DonNikolas/SmartKnob-ESP32/README.md

# SmartKnob-ESP32
Sound-controlled haptic smart knob for smart home control — ESP32-S3, FOC motor feedback, clap detection, MQTT/Home Assistant

## 3D-Render
cfa85a10-b2ae-4bf3-83a7-a0ef6e1e3006
