DonNikolas/SmartKnob-ESP32/electronics/SmartKnob-Screen/README.md

# SmartKnob Screen PCB

The screen PCB design was copied unchanged from SeedLabs.

Source: https://github.com/SeedLabs-it/smartknob-hardware

The original files are stored here for use with my SmartKnob project.
This PCB was not designed by me.

See license.md for the original SeedLabs hardware license.
