DonNikolas/SmartKnob-ESP32/reference/arduino-display-prototype/preview/SmartKnob_Animation.gif

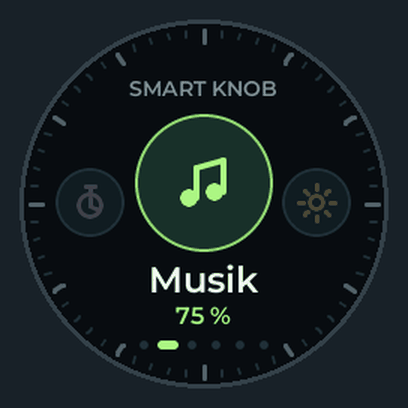
reference/arduino-display-prototype/preview/SmartKnob_Animation.gif
