DonNikolas/SmartKnob-ESP32/reference/arduino-display-prototype/preview/Uebersicht.png

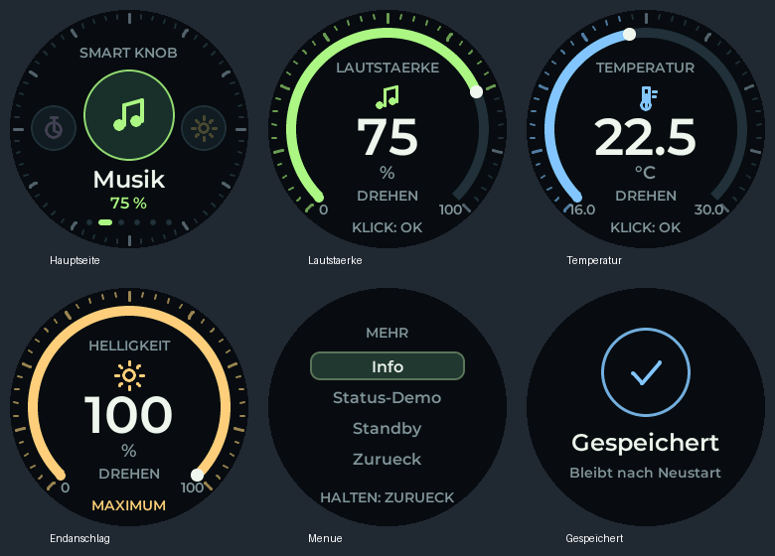
reference/arduino-display-prototype/preview/Uebersicht.png
