DonNikolas/SmartKnob-ESP32/reference/arduino-display-prototype/preview/Uhr_und_Helligkeit.png

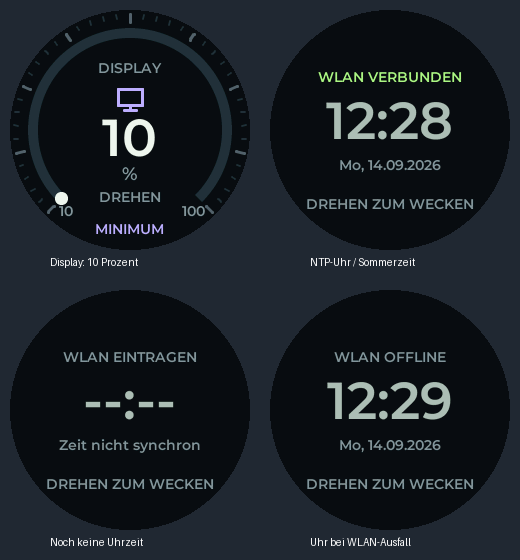
reference/arduino-display-prototype/preview/Uhr_und_Helligkeit.png
