DonNikolas/SmartKnob-ESP32/electronics/SmartKnob-Base/SmartKnob-NB.step

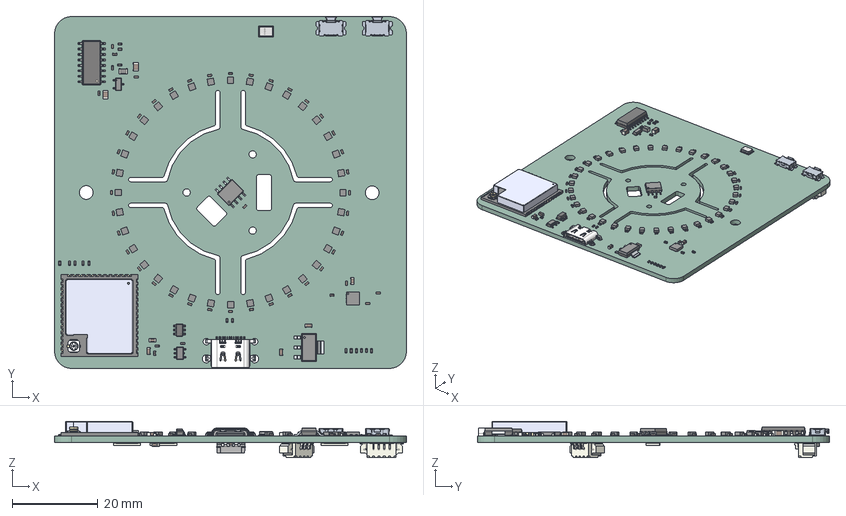
[picture p9: CAD file, 2026-10-14]
electronics/SmartKnob-Base/SmartKnob-NB.step
82.0 x 82.0 x 8.43 mm
C_0402_1005Metric x 50
Pins x 36
R_0402_1005Metric x 18
ESP32-S3-WROOM-1U-N16R8
C_0603_1608Metric x 6
C_0805_2012Metric x 2
SOP-16_4.4x10.4mm_P1.27mm
BODY-SOT
LEAD-SOT x 5
LEAD-DUMMY
PinsArrayL x 2
FilletPinR x 2
L_0805_2012Metric
ThermalPin
PinsArrayLR x 2
PinsArrayTB
SOT-23-6
USB4510
ICS-41350
Molex_53261_0471
Molex_53261_0371
VEML7700-TT
R_2512_6332Metric x 4
Bosch_LGA_8_25x25mm_P065mm_ClockwisePinNumbering
Sma8947_PCB
