DonNikolas/SmartKnob-ESP32/mechanical/enclosure-v4/Screen Platform.step

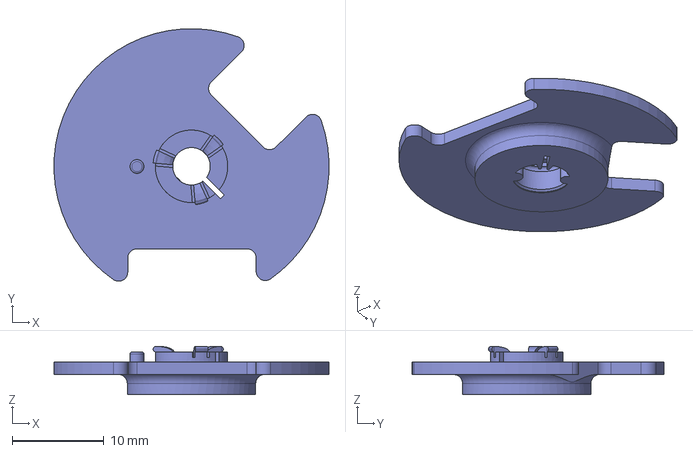
[picture p10: CAD file, 2026-10-22]
mechanical/enclosure-v4/Screen Platform.step
30.0 x 27.5 x 5.25 mm
