DonNikolas/SmartKnob-ESP32/mechanical/enclosure-v4/Back Plate v4.step

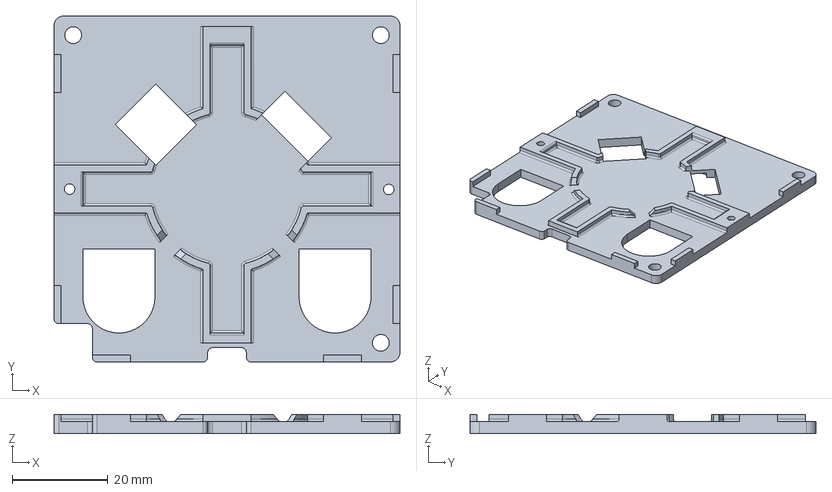
[picture p11: CAD file, 2026-10-22]
mechanical/enclosure-v4/Back Plate v4.step
72.2 x 72.2 x 4.00 mm
