DonNikolas/SmartKnob-ESP32/mechanical/enclosure-v4/Knob.step

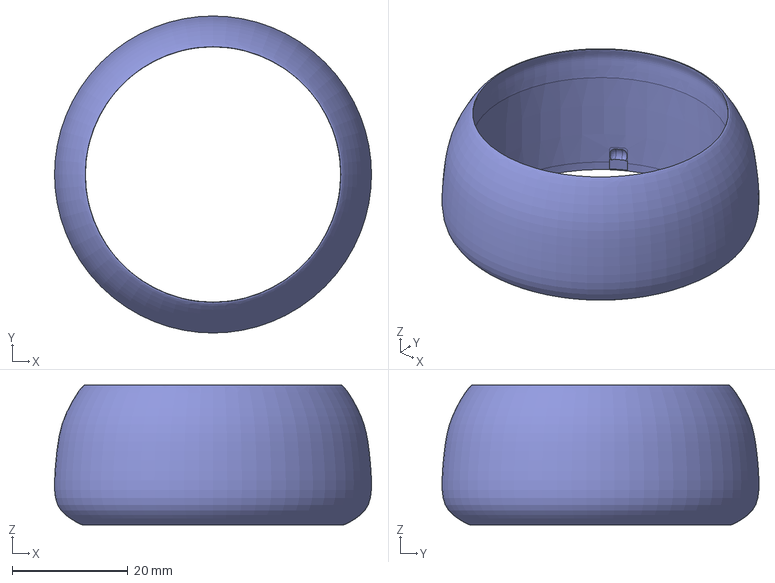
[picture p12: CAD file, 2026-10-21]
mechanical/enclosure-v4/Knob.step
54.8 x 54.8 x 24.2 mm
