DonNikolas/SmartKnob-ESP32/mechanical/enclosure-v4/Motor Spacer.step

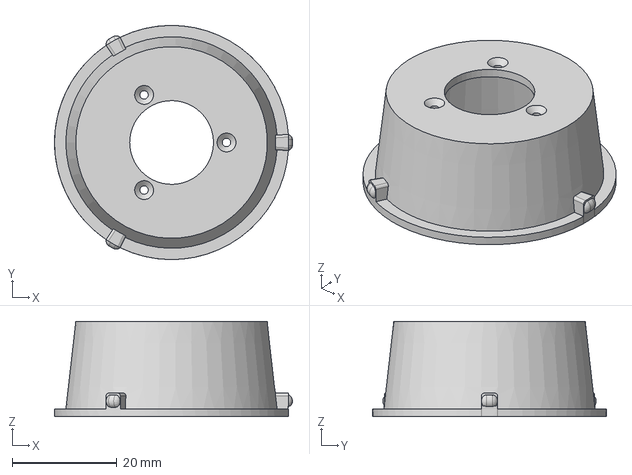
[picture p13: CAD file, 2026-10-21]
mechanical/enclosure-v4/Motor Spacer.step
45.5 x 44.8 x 18.2 mm
