DonNikolas/SmartKnob-ESP32/mechanical/enclosure-v3/Base Enclosure V3.step

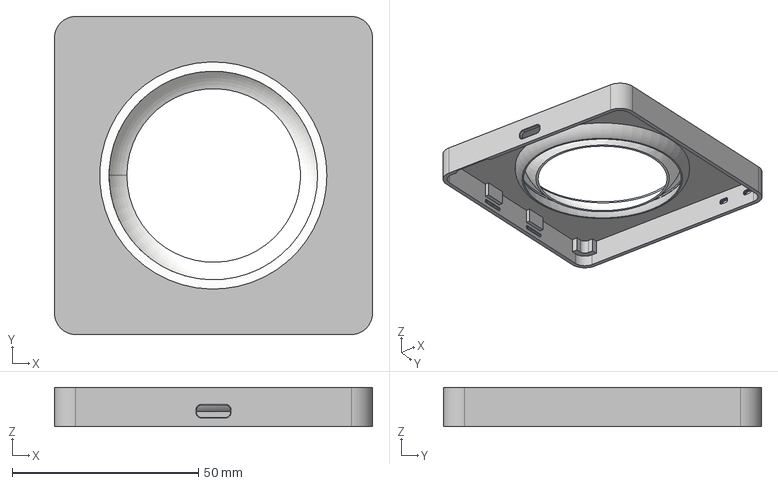
[picture p14: CAD file, 2026-10-19, an earlier design]
mechanical/enclosure-v3/Base Enclosure V3.step
85.4 x 85.4 x 10.5 mm
