DonNikolas/SmartKnob-ESP32/(list of files, cad)

Other CAD files:
mechanical/enclosure-v4/Button Set.step
mechanical/enclosure-v4/Motor Shaft.step
mechanical/enclosure-v4/Base Enclosure.step
mechanical/enclosure-v4/Display Spacer.step
mechanical/enclosure-v3/SmartKnob Enclosure Project.3mf
mechanical/enclosure-v3/SmartKnob-Assembly.f3z
mechanical/enclosure-v4/SmartKnob Enclosure.f3z
