DonNikolas/SmartKnob-ESP32/firmware/docs/tests/motor-offset-profile-01.txt

CALIBRATION v6: release rotor. About 2 minutes; x stops.
3 turns for direction, 20 forward + 20 reverse, then full-turn offset profiling.
Motor voltage: 0.50 V. Short TRACK LOST samples skipped; motion stays open-loop.
Pole pairs: 7 | Forward estimate: 7.041 | Reverse estimate: 7.062
Direction: CCW | Offset agreement: 23.08 electrical deg
Offset coherence: 0.906 / 0.922 | Electrical zero: 5.118509 rad
Samples: 116289 | CRC errors: 0 | TRACK LOST: 2490 | Weak field: 116289
RESULT: FAIL - electrical offset is not repeatable enough.
=== OFFSET PROFILE v6 - MOTOR OFF ===
Early window: 100-200 ms; late window: 700-800 ms after arrival.
Angles in degrees. Offset is electrical; settling and span are mechanical.
This profile includes motor, mechanics and sensor errors; it is not ground truth.
pass,step,command_elec_deg,sensor_mech_deg,offset_elec_deg,late_minus_early_mech_deg,late_span_mech_deg,early_samples,late_samples
FWD,0,0.000,247.799,65.407,-0.0062,0.2298,98,100
FWD,1,78.750,239.681,43.480,0.0202,0.1257,95,98
FWD,2,157.500,227.355,51.015,-0.0434,0.1319,97,99
FWD,3,236.250,217.053,44.381,0.0222,0.1328,98,99
FWD,4,315.000,208.491,25.561,0.0089,0.1598,99,101
FWD,5,393.750,195.226,39.666,0.0148,0.1144,98,100
FWD,6,472.500,184.145,38.484,0.0014,0.1332,96,98
FWD,7,551.250,175.053,23.378,0.0098,0.1185,98,99
FWD,8,630.000,161.505,39.461,0.0003,0.1456,100,101
FWD,9,708.750,152.231,25.633,0.0037,0.1309,98,101
FWD,10,787.500,141.175,24.276,0.0263,0.1468,99,99
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
REV,2,157.500,223.969,74.715,-0.0004,0.1414,99,99
REV,1,78.750,236.793,63.700,0.0292,0.1495,100,99
REV,0,0.000,247.785,65.504,-0.0056,0.2021,98,99
Maximum absolute settling: 0.0989 mechanical deg
Maximum late-window span: 0.2298 mechanical deg
Profile rows: 66/66
=== END OFFSET PROFILE ===
