DonNikolas/SmartKnob-ESP32/firmware/docs/tests/motor-offset-profile-02.txt

CALIBRATION v6: release rotor. About 2 minutes; x stops.
3 turns for direction, 20 forward + 20 reverse, then full-turn offset profiling.
Motor voltage: 0.50 V. Short TRACK LOST samples skipped; motion stays open-loop.
Pole pairs: 7 | Forward estimate: 6.968 | Reverse estimate: 6.990
Direction: CCW | Offset agreement: 23.26 electrical deg
Offset coherence: 0.918 / 0.909 | Electrical zero: 5.088051 rad
Samples: 116287 | CRC errors: 0 | TRACK LOST: 2275 | Weak field: 116287
RESULT: FAIL - electrical offset is not repeatable enough.
=== OFFSET PROFILE v6 - MOTOR OFF ===
Early window: 100-200 ms; late window: 700-800 ms after arrival.
Angles in degrees. Offset is electrical; settling and span are mechanical.
This profile includes motor, mechanics and sensor errors; it is not ground truth.
pass,step,command_elec_deg,sensor_mech_deg,offset_elec_deg,late_minus_early_mech_deg,late_span_mech_deg,early_samples,late_samples
FWD,0,0.000,101.263,11.158,-0.0478,0.1546,98,100
FWD,1,78.750,94.223,-18.315,-0.0364,0.1451,98,101
FWD,2,157.500,80.478,-0.846,0.0021,0.1157,99,99
FWD,3,236.250,69.659,-3.869,0.0033,0.1565,100,101
FWD,4,315.000,59.649,-12.548,-0.0109,0.0923,98,100
FWD,5,393.750,48.784,-15.242,-0.0707,0.1314,100,100
FWD,6,472.500,38.769,-23.885,0.0020,0.1104,99,98
FWD,7,551.250,28.590,-31.379,0.0043,0.1305,97,101
FWD,8,630.000,16.055,-22.388,0.0320,0.1325,97,101
FWD,9,708.750,5.448,-26.890,-0.0278,0.1777,98,97
FWD,10,787.500,351.016,-4.618,-0.0126,0.1559,99,98
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
REV,2,157.500,77.616,19.184,-0.0078,0.1611,98,99
REV,1,78.750,88.979,18.393,0.0207,0.1534,99,98
REV,0,0.000,101.257,11.200,0.0103,0.1409,95,100
Maximum absolute settling: 0.0707 mechanical deg
Maximum late-window span: 0.2004 mechanical deg
Profile rows: 66/66
=== END OFFSET PROFILE ===
