DonNikolas/SmartKnob-ESP32/firmware/docs/tests/microphone-test.txt

Time: 7 s | RMS: 8.0 | P-P: 92 | Mean: 608.8 | Clipped: 0 | Samples: 8192
Time: 7 s | RMS: 8.2 | P-P: 108 | Mean: 608.6 | Clipped: 0 | Samples: 8192
Time: 8 s | RMS: 8.3 | P-P: 113 | Mean: 609.2 | Clipped: 0 | Samples: 8192
Time: 8 s | RMS: 8.2 | P-P: 95 | Mean: 608.7 | Clipped: 0 | Samples: 8192
Time: 9 s | RMS: 8.1 | P-P: 96 | Mean: 608.7 | Clipped: 0 | Samples: 8192
Time: 9 s | RMS: 8.1 | P-P: 90 | Mean: 608.3 | Clipped: 0 | Samples: 8192
Time: 10 s | RMS: 8.4 | P-P: 103 | Mean: 608.4 | Clipped: 0 | Samples: 8192
Time: 10 s | RMS: 8.2 | P-P: 100 | Mean: 609.0 | Clipped: 0 | Samples: 8192
Time: 11 s | RMS: 8.2 | P-P: 103 | Mean: 608.5 | Clipped: 0 | Samples: 8192
Time: 11 s | RMS: 8.3 | P-P: 99 | Mean: 609.2 | Clipped: 0 | Samples: 8192
Time: 12 s | RMS: 8.1 | P-P: 108 | Mean: 609.0 | Clipped: 0 | Samples: 8192
Time: 12 s | RMS: 8.2 | P-P: 109 | Mean: 608.8 | Clipped: 0 | Samples: 8192
Time: 13 s | RMS: 8.0 | P-P: 106 | Mean: 608.4 | Clipped: 0 | Samples: 8192
Time: 13 s | RMS: 7.9 | P-P: 90 | Mean: 609.5 | Clipped: 0 | Samples: 8192
Time: 14 s | RMS: 8.0 | P-P: 99 | Mean: 608.5 | Clipped: 0 | Samples: 8192
Time: 14 s | RMS: 8.1 | P-P: 105 | Mean: 608.6 | Clipped: 0 | Samples: 8192
Time: 15 s | RMS: 8.1 | P-P: 105 | Mean: 608.6 | Clipped: 0 | Samples: 8192
Time: 15 s | RMS: 8.4 | P-P: 97 | Mean: 609.3 | Clipped: 0 | Samples: 8192
Time: 16 s | RMS: 8.5 | P-P: 101 | Mean: 608.8 | Clipped: 0 | Samples: 8192
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
Time: 85 s | RMS: 8.2 | P-P: 111 | Mean: 608.7 | Clipped: 0 | Samples: 8192
Time: 85 s | RMS: 7.8 | P-P: 94 | Mean: 608.7 | Clipped: 0 | Samples: 8192
Time: 86 s | RMS: 8.3 | P-P: 101 | Mean: 608.5 | Clipped: 0 | Samples: 8192
Time: 86 s | RMS: 8.1 | P-P: 109 | Mean: 608.6 | Clipped: 0 | Samples: 8192
Time: 87 s | RMS: 8.1 | P-P: 102 | Mean: 608.9 | Clipped: 0 | Samples: 8192
Time: 87 s | RMS: 7.9 | P-P: 96 | Mean: 609.5 | Clipped: 0 | Samples: 8192
Time: 88 s | RMS: 8.3 | P-P: 107 | Mean: 608.4 | Clipped: 0 | Samples: 8192
Time: 88 s | RMS: 8.0 | P-P: 95 | Mean: 609.2 | Clipped: 0 | Samples: 8192
Time: 89 s | RMS: 8.0 | P-P: 104 | Mean: 609.0 | Clipped: 0 | Samples: 8192
Time: 89 s | RMS: 8.0 | P-P: 105 | Mean: 609.8 | Clipped: 0 | Samples: 8192
Time: 90 s | RMS: 8.0 | P-P: 118 | Mean: 609.0 | Clipped: 0 | Samples: 8192
Time: 90 s | RMS: 7.8 | P-P: 103 | Mean: 609.0 | Clipped: 0 | Samples: 8192
Time: 91 s | RMS: 7.8 | P-P: 84 | Mean: 609.2 | Clipped: 0 | Samples: 8192
Time: 92 s | RMS: 7.6 | P-P: 100 | Mean: 610.0 | Clipped: 0 | Samples: 8192
Time: 92 s | RMS: 8.3 | P-P: 102 | Mean: 609.2 | Clipped: 0 | Samples: 8192
Time: 93 s | RMS: 8.0 | P-P: 104 | Mean: 608.8 | Clipped: 0 | Samples: 8192
Time: 93 s | RMS: 8.4 | P-P: 105 | Mean: 608.9 | Clipped: 0 | Samples: 8192
Time: 94 s | RMS: 8.2 | P-P: 106 | Mean: 609.0 | Clipped: 0 | Samples: 8192
Time: 94 s | RMS: 8.1 | P-P: 116 | Mean: 608.9 | Clipped: 0 | Samples: 8192
Time: 95 s | RMS: 8.2 | P-P: 102 | Mean: 609.1 | Clipped: 0 | Samples: 8192
Time: 95 s | RMS: 8.1 | P-P: 102 | Mean: 609.3 | Clipped: 0 | Samples: 8192
Time: 96 s | RMS: 8.3 | P-P: 105 | Mean: 608.4 | Clipped: 0 | Samples: 8192
Time: 96 s | RMS: 8.1 | P-P: 114 | Mean: 609.6 | Clipped: 0 | Samples: 8192
