DonNikolas/SmartKnob-ESP32/electronics/SmartKnob-Screen/view_screen.kicad_pcb

## KiCad design electronics/SmartKnob-Screen/view_screen.kicad_pcb (2026-10-14)

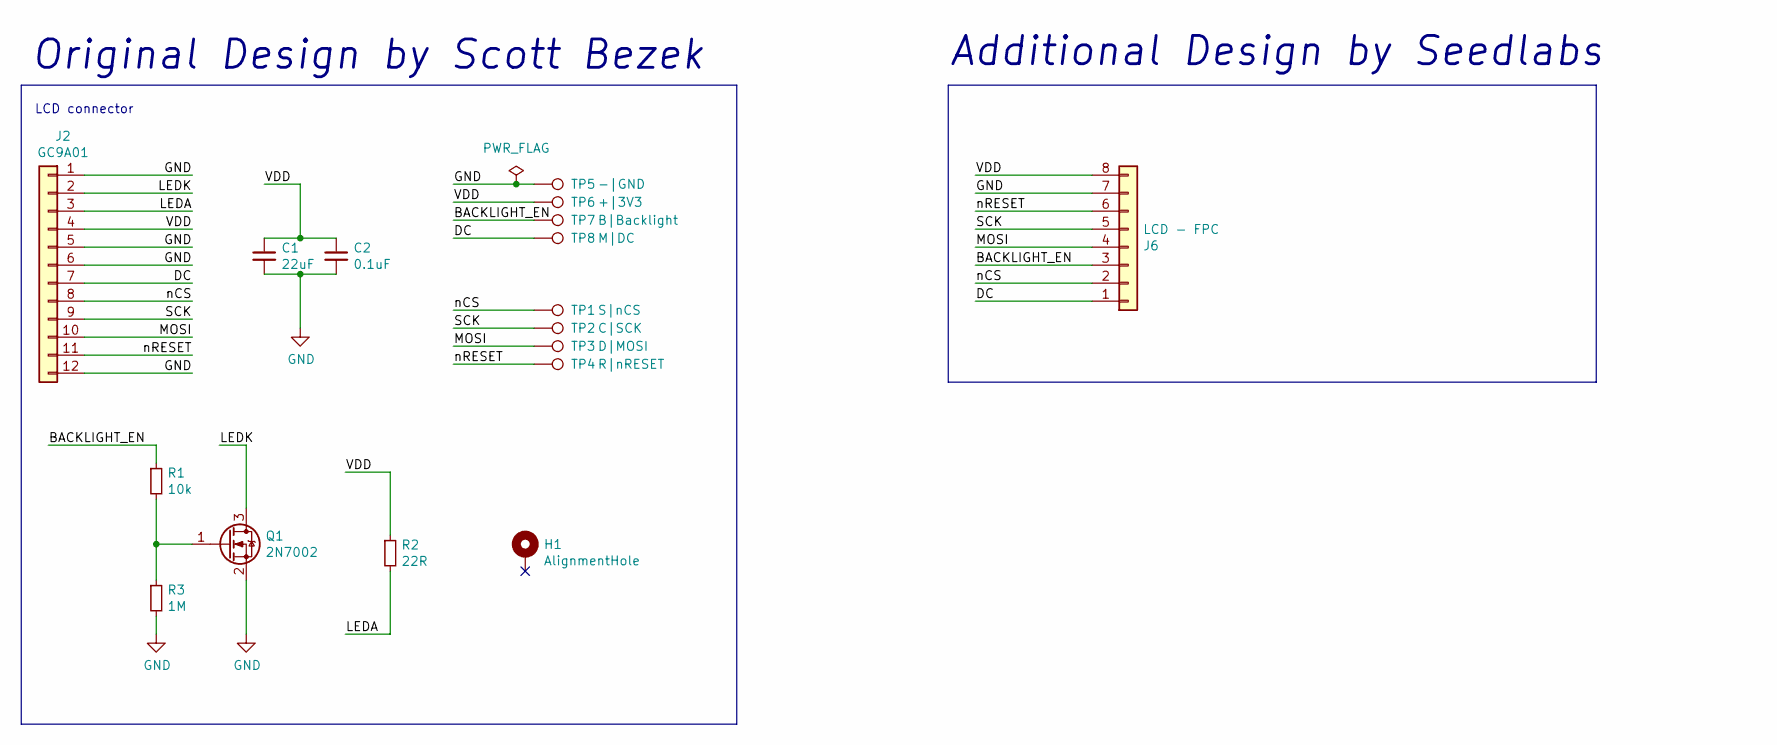
[picture p15: schematic view_screen.kicad_sch, SmartKnob DevKit Screen]

Parts:
C1: 22uF; C_0603_1608Metric; Digikey 1276-CL21A226MAYNNNECT-ND
C2: 0.1uF; C_0603_1608Metric; Digikey 1276-1935-1-ND
H1: AlignmentHole; AlignmentHole_1.6
J2: GC9A01; GC9A01Round1.28; Digikey N/A
J6: LCD - FPC; Amphenol FCI FPC 8 pin 0.5 pitch; Mouser 649-59453081110EDHLF
Q1: 2N7002; SOT-23; Digikey 2N7002H6327XTSA2CT-ND
R1: 10k; R_0603_1608Metric; Digikey RMCF0603JT10K0CT-ND
R2: 22R; R_0603_1608Metric; Digikey RMCF0603JT22R0CT-ND
R3: 1M; R_0603_1608Metric; Digikey RMCF0603JT1M00CT-ND
TP1: S|nCS; test_point_connectivity
TP2: C|SCK; test_point_connectivity
TP3: D|MOSI; test_point_connectivity
TP4: R|nRESET; test_point_connectivity
TP5: -|GND; test_point_connectivity
TP6: +|3V3; test_point_connectivity
TP7: B|Backlight; test_point_connectivity
TP8: M|DC; test_point_connectivity

Connections:
/BACKLIGHT_EN: J6.3, R1.1, TP7.1
/DC: J2.7, J6.1, TP8.1
/LEDA: J2.3, R2.2
/LEDK: J2.2, Q1.3 (D)
/MOSI: J2.10, J6.4, TP3.1
/SCK: J2.9, J6.5, TP2.1
/VDD: C1.1, C2.1, J2.4, J6.8, R2.1, TP6.1
/nCS: J2.8, J6.2, TP1.1
/nRESET: J2.11, J6.6, TP4.1
GND: C1.2, C2.2, J2.1, J2.5, J2.6, J2.12, J6.7, Q1.2 (S), R3.2, TP5.1
unnamed: Q1.1 (G), R1.2, R3.1

Notes on the sheet:
Additional Design by Seedlabs
LCD connector
Original Design by Scott Bezek

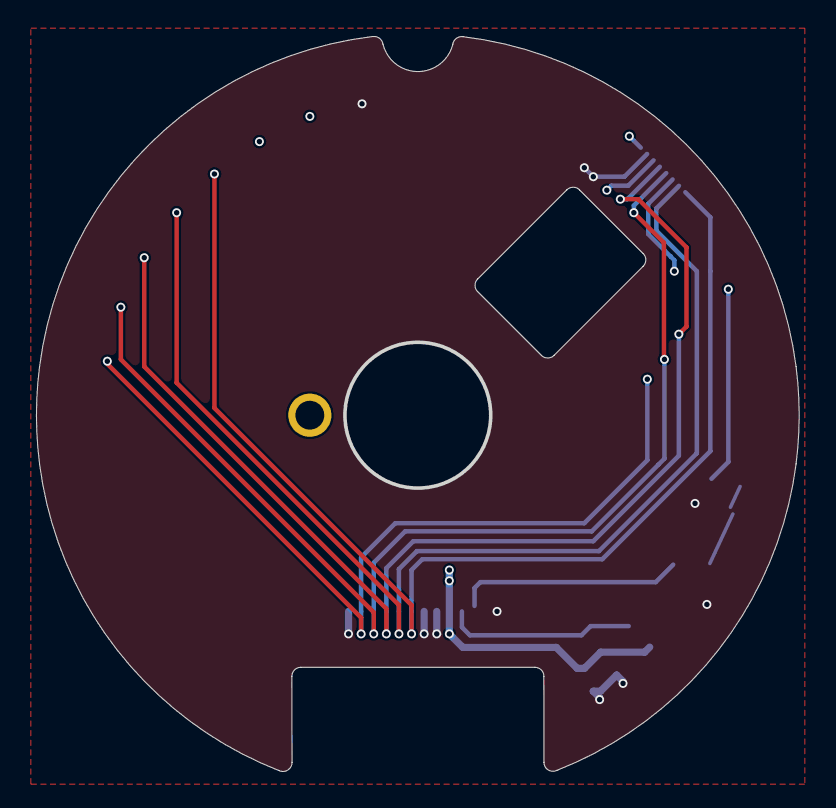
[picture p16: board view_screen.kicad_pcb from above]

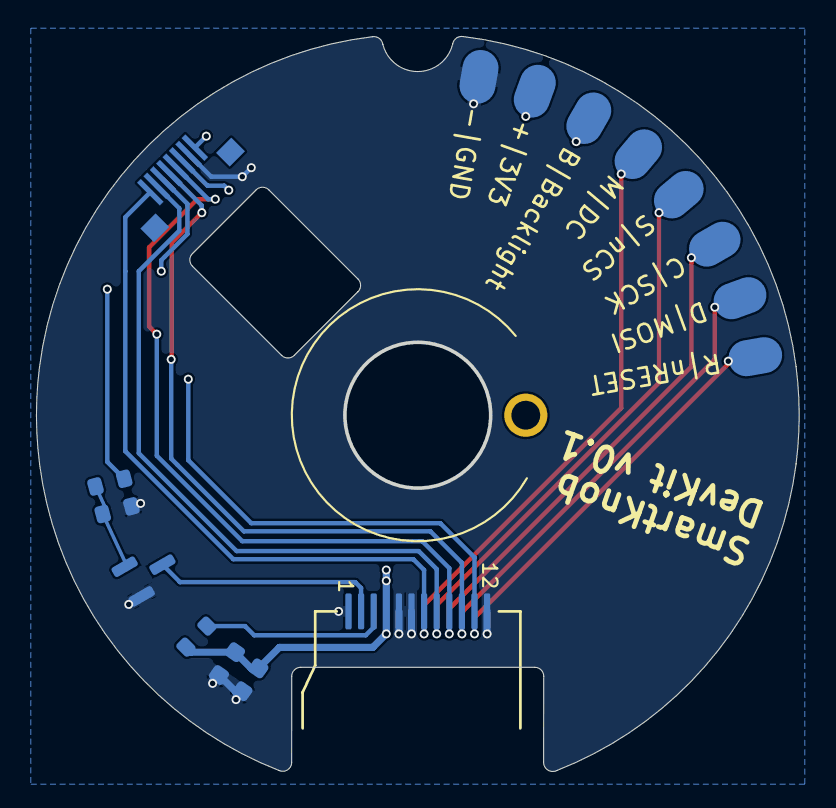
[picture p17: board view_screen.kicad_pcb from below]

Board: 4 copper layers, 42.4 x 40.8 mm, 17 parts (16 on the bottom side), 11 nets.
