DonNikolas/SmartKnob-ESP32/electronics/SmartKnob-Base/SmartKnob-NB.kicad_pcb

## KiCad design electronics/SmartKnob-Base/SmartKnob-NB.kicad_pcb (2026-10-14)

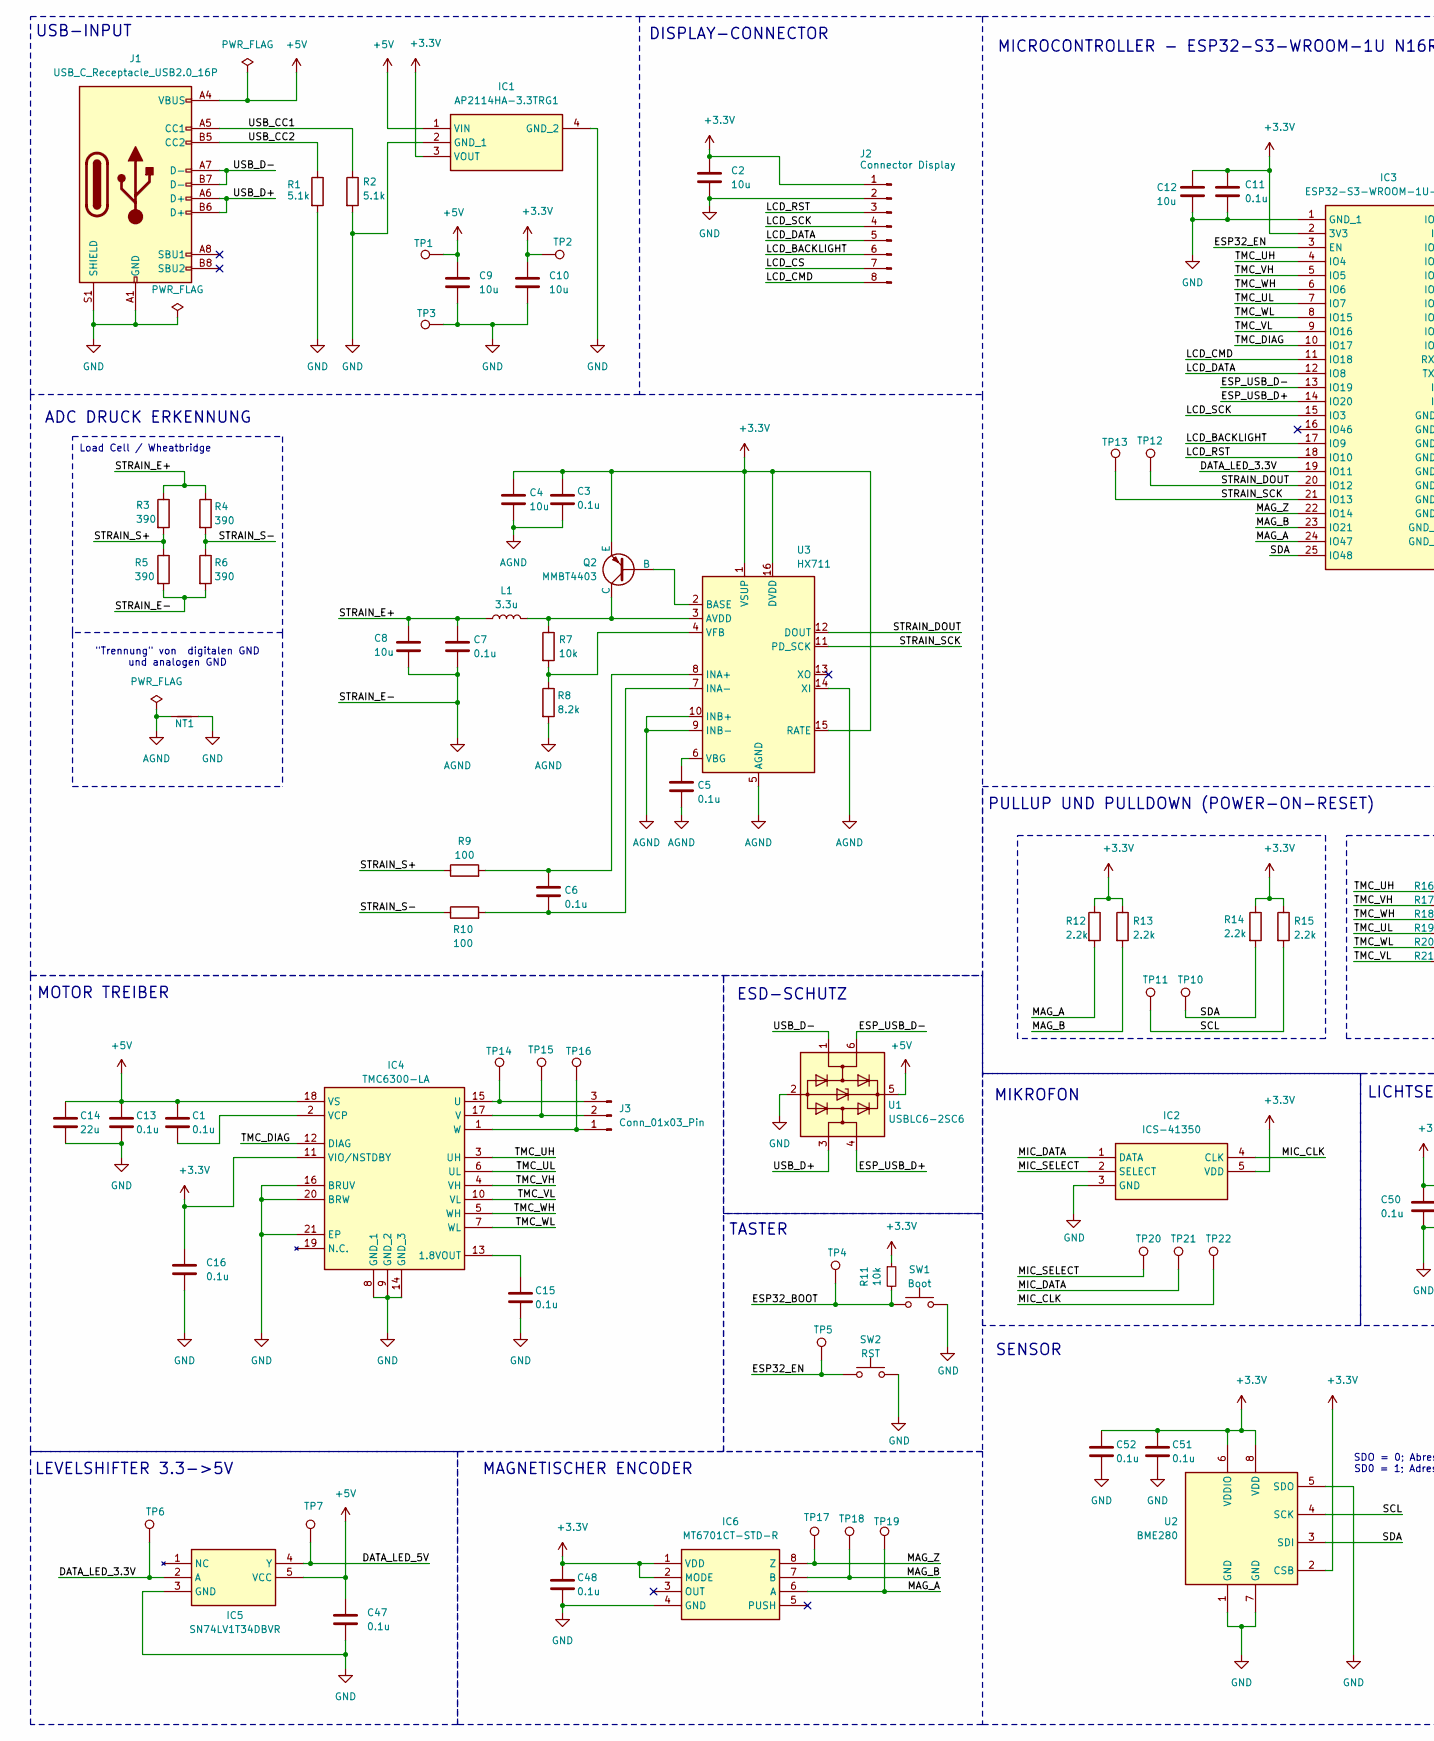
[picture p18: schematic SmartKnob-NB.kicad_sch, part in row 1, column 1]

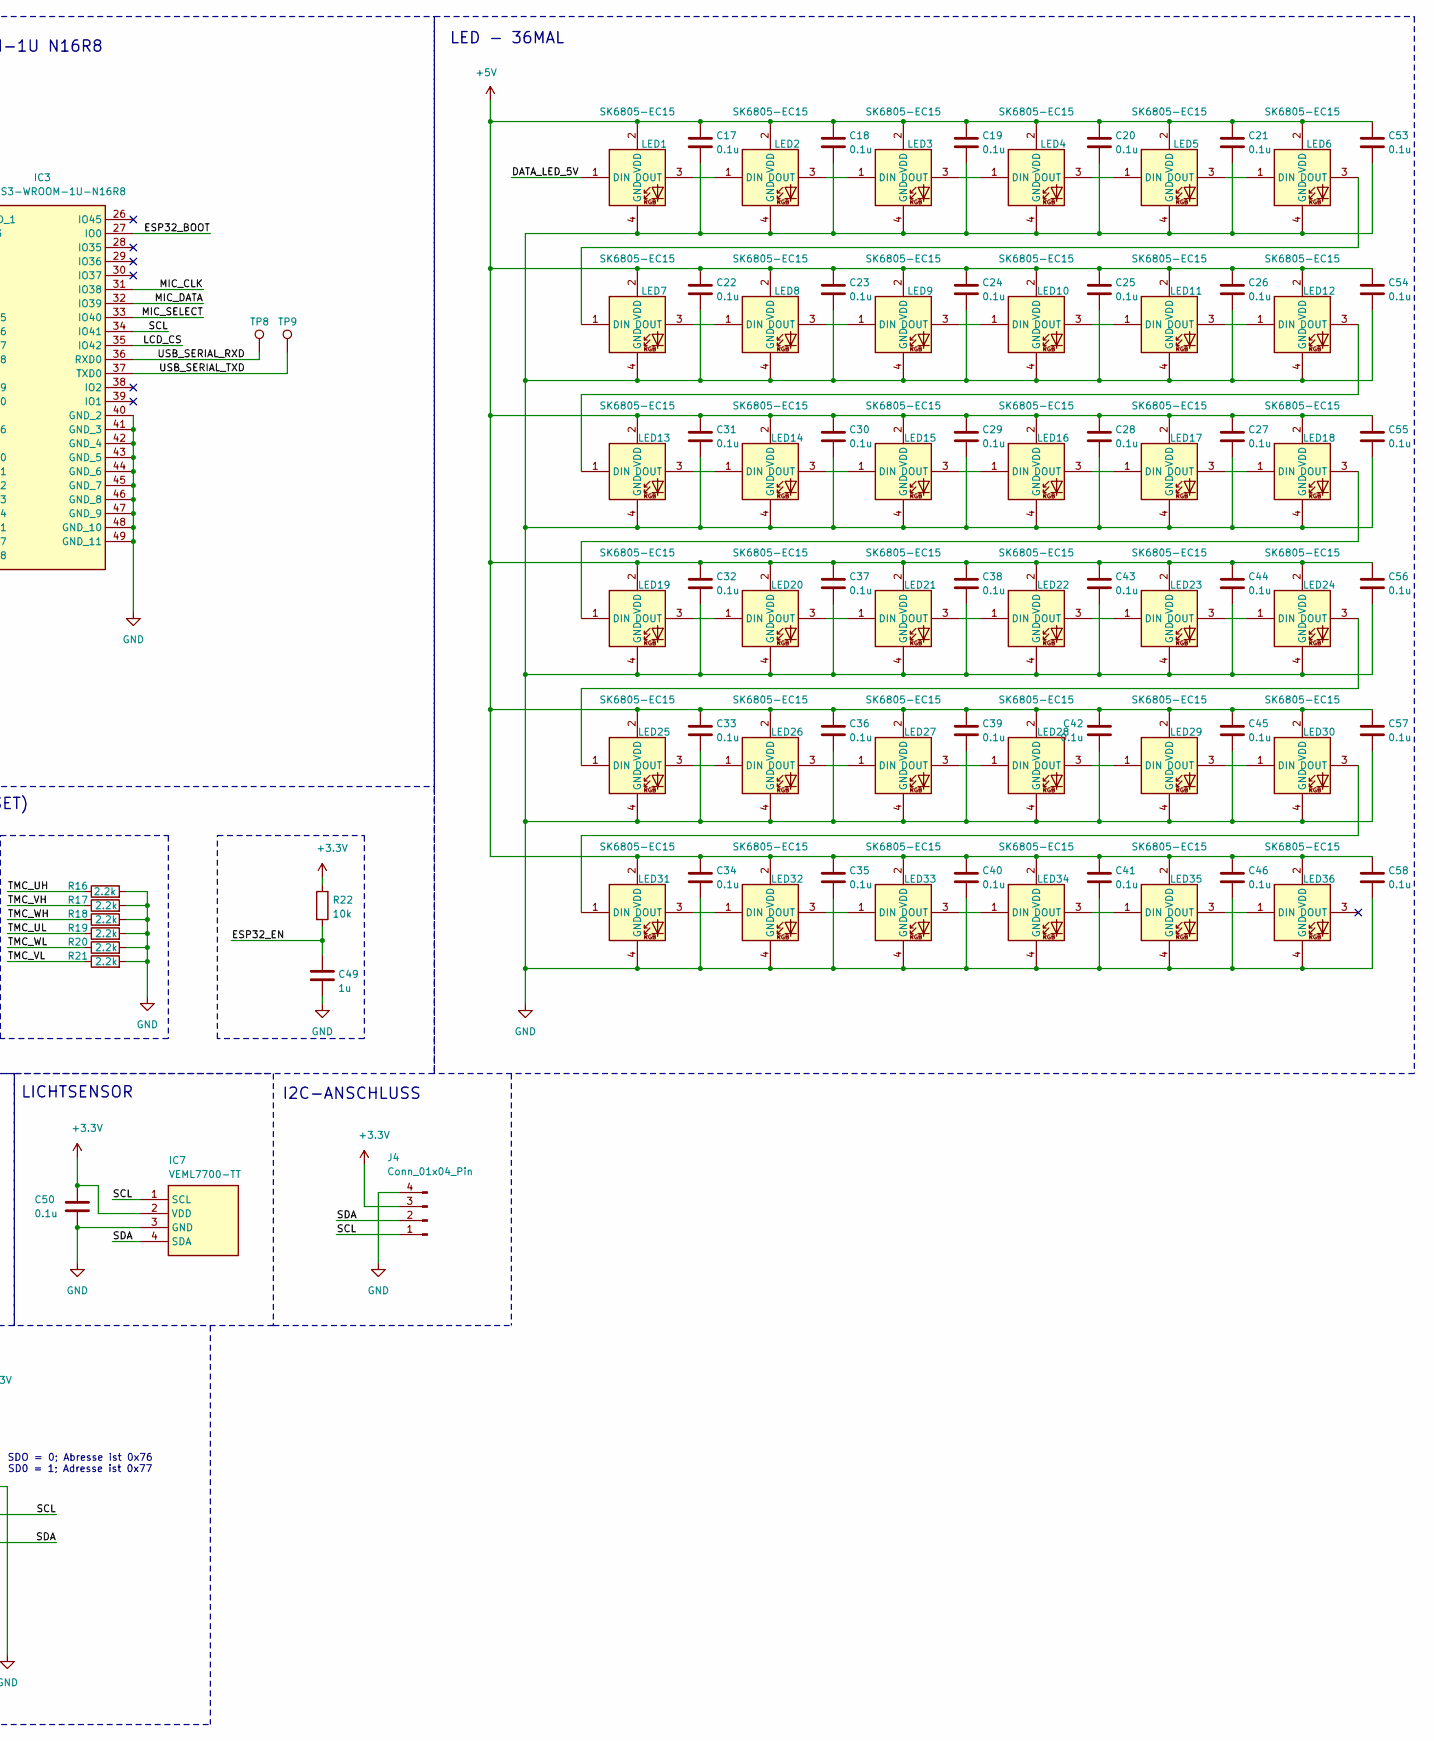
[picture p19: schematic SmartKnob-NB.kicad_sch, part in row 1, column 2]

Parts:
C1, C3, C5, C6, C7, C11, C13, C15, C16, C17, C18, C19, C20, C21, C22, C23, C24, C25, C26, C27, C28, C29, C30, C31, C32, C33, C34, C35, C36, C37, C38, C39, C40, C41, C42, C43, C44, C45, C46, C47, C48, C50, C51, C52, C53, C54, C55, C56, C57, C58: 0.1u; C_0402_1005Metric_Pad0.74x0.62mm_HandSolder
C2, C9, C10, C12: 10u; C_0603_1608Metric_Pad1.08x0.95mm_HandSolder
C4, C8: 10u; C_0805_2012Metric_Pad1.18x1.45mm_HandSolder
C14: 22u; C_0603_1608Metric_Pad1.08x0.95mm_HandSolder
C49: 1u; C_0603_1608Metric_Pad1.08x0.95mm_HandSolder
IC1: AP2114HA-3.3TRG1; SOT230P700X180-4N; Manufacturer_Part_Number AP2114HA-3.3TRG1; Mouser Part Number 621-AP2114HA-3.3TRG1
IC2: ICS-41350; ICS41352; Manufacturer_Part_Number ICS-41350; Mouser Part Number 410-ICS-41350
IC3: ESP32-S3-WROOM-1U-N16R8; ESP32S3WROOM1UN16R8; Manufacturer_Part_Number ESP32-S3-WROOM-1U-N16R8; Mouser Part Number 356-ESP32S3WM1UN16R8
IC4: TMC6300-LA; QFN40P300X300X90-21N; Manufacturer_Part_Number TMC6300-LA; Mouser Part Number 700-TMC6300-LA
IC5: SN74LV1T34DBVR; SOT95P280X145-5N; Manufacturer_Part_Number SN74LV1T34DBVR; Mouser Part Number 595-SN74LV1T34DBVR
IC6: MT6701CT-STD-R; SOIC127P600X175-8N; Manufacturer_Part_Number MT6701CT-STD-R
IC7: VEML7700-TT; VEML7700; Manufacturer_Part_Number VEML7700-TT; Mouser Part Number 78-VEML7700-TT
J1: USB_C_Receptacle_USB2.0_16P; USB4510031A
J2: Connector Display; Unbenannt
J3: Conn_01x03_Pin; Molex_CLIK-Mate_502386-0370_1x03-1MP_P1.25mm_Horizontal
J4: Conn_01x04_Pin; Unbenannt
L1: 3.3u; L_0805_2012Metric_Pad1.05x1.20mm_HandSolder
LED1, LED2, LED3, LED4, LED5, LED6, LED7, LED8, LED9, LED10, LED11, LED12, LED13, LED14, LED15, LED16, LED17, LED18, LED19, LED20, LED21, LED22, LED23, LED24, LED25, LED26, LED27, LED28, LED29, LED30, LED31, LED32, LED33, LED34, LED35, LED36: SK6805-EC15; SK6805EC15; Manufacturer_Part_Number SK6805-EC15
NT1: NetTie_2; NetTie-2_SMD_Pad0.5mm
Q2: MMBT4403; SOT95P248X115-3N
R1, R2: 5.1k; R_0402_1005Metric_Pad0.72x0.64mm_HandSolder
R3, R4, R5, R6: 390; D_2512_6332Metric
R7, R22: 10k; R_0402_1005Metric_Pad0.72x0.64mm_HandSolder
R8: 8.2k; R_0402_1005Metric_Pad0.72x0.64mm_HandSolder
R9, R10: 100; R_0402_1005Metric_Pad0.72x0.64mm_HandSolder
R11: 10k; R_0402_1005Metric_Pad0.72x0.64mm_HandSolder; LCSC C98220
R12, R13, R14, R15, R16, R17, R18, R19, R20, R21: 2.2k; R_0402_1005Metric_Pad0.72x0.64mm_HandSolder
SW1: Boot; KSS241GLFS; LCSC C116501
SW2: RST; KSS241GLFS; LCSC C116501
TP1, TP2, TP3, TP4, TP5, TP6, TP7, TP8, TP9, TP10, TP11, TP12, TP13, TP14, TP15, TP16, TP17, TP18, TP19, TP20, TP21, TP22: TestPoint; TestPoint_Pad_1.5x1.5mm
U1: USBLC6-2SC6; SOT-23-6_Handsoldering; LCSC C7519
U2: BME280; Bosch_LGA-8_2.5x2.5mm_P0.65mm_ClockwisePinNumbering
U3: HX711; SOP-16_4.4x10.4mm_P1.27mm

Connections:
+3.3V: C2.1, C3.1, C4.1, C10.1, C11.1, C12.1, C16.1, C48.1, C50.1, C51.1, C52.1, IC1.3 (VOUT), IC2.5 (VDD), IC3.2 (3V3), IC4.11 (VIO/NSTDBY), IC6.1 (VDD), IC6.2 (MODE), IC7.2 (VDD), J2.1, J4.3, Q2.3 (E), R11.1, R12.1, R13.1, R14.1, R15.1, R22.1, TP2.1 (1_1), U2.2 (CSB), U2.6 (VDDIO), U2.8 (VDD), U3.1 (VSUP), U3.15 (RATE), U3.16 (DVDD)
+5V: C1.1, C9.1, C13.1, C14.1, C17.1, C18.1, C19.1, C20.1, C21.1, C22.1, C23.1, C24.1, C25.1, C26.1, C27.1, C28.1, C29.1, C30.1, C31.1, C32.1, C33.1, C34.1, C35.1, C36.1, C37.1, C38.1, C39.1, C40.1, C41.1, C42.1, C43.1, C44.1, C45.1, C46.1, C47.1, C53.1, C54.1, C55.1, C56.1, C57.1, C58.1, IC1.1 (VIN), IC4.18 (VS), IC5.5 (VCC), J1.A4 (VBUS), J1.A9 (VBUS), J1.B4 (VBUS), J1.B9 (VBUS), LED1.2 (VDD), LED2.2 (VDD), LED3.2 (VDD), LED4.2 (VDD), LED5.2 (VDD), LED6.2 (VDD), LED7.2 (VDD), LED8.2 (VDD), LED9.2 (VDD), LED10.2 (VDD), LED11.2 (VDD), LED12.2 (VDD), LED13.2 (VDD), LED14.2 (VDD), LED15.2 (VDD), LED16.2 (VDD), LED17.2 (VDD), LED18.2 (VDD), LED19.2 (VDD), LED20.2 (VDD), LED21.2 (VDD), LED22.2 (VDD), LED23.2 (VDD), LED24.2 (VDD), LED25.2 (VDD), LED26.2 (VDD), LED27.2 (VDD), LED28.2 (VDD), LED29.2 (VDD), LED30.2 (VDD), LED31.2 (VDD), LED32.2 (VDD), LED33.2 (VDD), LED34.2 (VDD), LED35.2 (VDD), LED36.2 (VDD), TP1.1 (1_1), U1.5 (VBUS)
/DATA_LED_3.3V: IC3.19 (IO11), IC5.2 (A), TP6.1 (1_1)
/DATA_LED_5V: IC5.4 (Y), LED1.1 (DIN), TP7.1 (1_1)
/ESP32_BOOT: IC3.27 (IO0), R11.2, SW1.1, TP4.1 (1_1)
/ESP32_EN: C49.1, IC3.3 (EN), R22.2, SW2.1, TP5.1 (1_1)
/ESP_USB_D+: IC3.14 (IO20), U1.4 (I/O2)
/ESP_USB_D-: IC3.13 (IO19), U1.6 (I/O1)
/LCD_BACKLIGHT: IC3.17 (IO9), J2.6
/LCD_CMD: IC3.11 (IO18), J2.8
/LCD_CS: IC3.35 (IO42), J2.7
/LCD_DATA: IC3.12 (IO8), J2.5
/LCD_RST: IC3.18 (IO10), J2.3
/LCD_SCK: IC3.15 (IO3), J2.4
/MAG_A: IC3.24 (IO47), IC6.6 (A), R12.2, TP19.1 (1_1)
/MAG_B: IC3.23 (IO21), IC6.7 (B), R13.2, TP18.1 (1_1)
/MAG_Z: IC3.22 (IO14), IC6.8 (Z), TP17.1 (1_1)
/MIC_CLK: IC2.4 (CLK), IC3.31 (IO38), TP22.1 (1_1)
/MIC_DATA: IC2.1 (DATA), IC3.32 (IO39), TP21.1 (1_1)
/MIC_SELECT: IC2.2 (SELECT), IC3.33 (IO40), TP20.1 (1_1)
/SCL: IC3.34 (IO41), IC7.1 (SCL), J4.1, R15.2, TP11.1 (1_1), U2.4 (SCK)
/SDA: IC3.25 (IO48), IC7.4 (SDA), J4.2, R14.2, TP10.1 (1_1), U2.3 (SDI)
/STRAIN_DOUT: IC3.20 (IO12), TP12.1 (1_1), U3.12 (DOUT)
/STRAIN_E+: C7.1, C8.1, L1.1, R3.1, R4.1
/STRAIN_S+: R3.2, R5.1, R9.1
/STRAIN_S-: R4.2, R6.1, R10.1
/STRAIN_SCK: IC3.21 (IO13), TP13.1 (1_1), U3.11 (PD_SCK)
/TMC_DIAG: IC3.10 (IO17), IC4.12 (DIAG)
/TMC_UH: IC3.4 (IO4), IC4.3 (UH), R16.1
/TMC_UL: IC3.7 (IO7), IC4.6 (UL), R19.1
/TMC_VH: IC3.5 (IO5), IC4.4 (VH), R17.1
/TMC_VL: IC3.9 (IO16), IC4.10 (VL), R21.1
/TMC_WH: IC3.6 (IO6), IC4.5 (WH), R18.1
/TMC_WL: IC3.8 (IO15), IC4.7 (WL), R20.1
/USB_CC1: J1.A5 (CC1), R2.1
/USB_CC2: J1.B5 (CC2), R1.1
/USB_D+: J1.A6 (D+), J1.B6 (D+), U1.3 (I/O2)
/USB_D-: J1.A7 (D-), J1.B7 (D-), U1.1 (I/O1)
/USB_SERIAL_RXD: IC3.36 (RXD0), TP8.1 (1_1)
/USB_SERIAL_TXD: IC3.37 (TXD0), TP9.1 (1_1)
AGND: C3.2, C4.2, C5.2, C7.2, C8.2, NT1.1, R5.2, R6.2, R8.2, U3.5 (AGND), U3.9 (INB-), U3.10 (INB+), U3.14 (XI)
GND: C2.2, C9.2, C10.2, C11.2, C12.2, C13.2, C14.2, C15.2, C16.2, C17.2, C18.2, C19.2, C20.2, C21.2, C22.2, C23.2, C24.2, C25.2, C26.2, C27.2, C28.2, C29.2, C30.2, C31.2, C32.2, C33.2, C34.2, C35.2, C36.2, C37.2, C38.2, C39.2, C40.2, C41.2, C42.2, C43.2, C44.2, C45.2, C46.2, C47.2, C48.2, C49.2, C50.2, C51.2, C52.2, C53.2, C54.2, C55.2, C56.2, C57.2, C58.2, IC1.2 (GND_1), IC1.4 (GND_2), IC2.3 (GND), IC3.1 (GND_1), IC3.40 (GND_2), IC3.41 (GND_3), IC3.42 (GND_4), IC3.43 (GND_5), IC3.44 (GND_6), IC3.45 (GND_7), IC3.46 (GND_8), IC3.47 (GND_9), IC3.48 (GND_10), IC3.49 (GND_11), IC4.8 (GND_1), IC4.9 (GND_2), IC4.14 (GND_3), IC4.16 (BRUV), IC4.20 (BRW), IC4.21 (EP), IC5.3 (GND), IC6.4 (GND), IC7.3 (GND), J1.A1 (GND), J1.A12 (GND), J1.B1 (GND), J1.B12 (GND), J1.S1 (SHIELD), J2.2, J4.4, LED1.4 (GND), LED2.4 (GND), LED3.4 (GND), LED4.4 (GND), LED5.4 (GND), LED6.4 (GND), LED7.4 (GND), LED8.4 (GND), LED9.4 (GND), LED10.4 (GND), LED11.4 (GND), LED12.4 (GND), LED13.4 (GND), LED14.4 (GND), LED15.4 (GND), LED16.4 (GND), LED17.4 (GND), LED18.4 (GND), LED19.4 (GND), LED20.4 (GND), LED21.4 (GND), LED22.4 (GND), LED23.4 (GND), LED24.4 (GND), LED25.4 (GND), LED26.4 (GND), LED27.4 (GND), LED28.4 (GND), LED29.4 (GND), LED30.4 (GND), LED31.4 (GND), LED32.4 (GND), LED33.4 (GND), LED34.4 (GND), LED35.4 (GND), LED36.4 (GND), NT1.2, R1.2, R2.2, R16.2, R17.2, R18.2, R19.2, R20.2, R21.2, SW1.2, SW2.2, TP3.1 (1_1), U1.2 (GND), U2.1 (GND), U2.5 (SDO), U2.7 (GND)
unnamed: C15.1, IC4.13 (1.8VOUT)
unnamed: IC4.15 (U), J3.3, TP14.1 (1_1)
unnamed: IC4.17 (V), J3.2, TP15.1 (1_1)
unnamed: C1.2, IC4.2 (VCP)
unnamed: IC4.1 (W), J3.1, TP16.1 (1_1)
unnamed: LED1.3 (DOUT), LED2.1 (DIN)
unnamed: LED2.3 (DOUT), LED3.1 (DIN)
unnamed: LED3.3 (DOUT), LED4.1 (DIN)
unnamed: LED4.3 (DOUT), LED5.1 (DIN)
unnamed: LED5.3 (DOUT), LED6.1 (DIN)
unnamed: LED6.3 (DOUT), LED7.1 (DIN)
unnamed: LED7.3 (DOUT), LED8.1 (DIN)
unnamed: LED8.3 (DOUT), LED9.1 (DIN)
unnamed: LED9.3 (DOUT), LED10.1 (DIN)
unnamed: LED10.3 (DOUT), LED11.1 (DIN)
unnamed: LED11.3 (DOUT), LED12.1 (DIN)
unnamed: LED12.3 (DOUT), LED13.1 (DIN)
unnamed: LED13.3 (DOUT), LED14.1 (DIN)
unnamed: LED14.3 (DOUT), LED15.1 (DIN)
unnamed: LED15.3 (DOUT), LED16.1 (DIN)
unnamed: LED16.3 (DOUT), LED17.1 (DIN)
unnamed: LED17.3 (DOUT), LED18.1 (DIN)
unnamed: LED18.3 (DOUT), LED19.1 (DIN)
unnamed: LED19.3 (DOUT), LED20.1 (DIN)
unnamed: LED20.3 (DOUT), LED21.1 (DIN)
unnamed: LED21.3 (DOUT), LED22.1 (DIN)
unnamed: LED22.3 (DOUT), LED23.1 (DIN)
unnamed: LED23.3 (DOUT), LED24.1 (DIN)
unnamed: LED24.3 (DOUT), LED25.1 (DIN)
unnamed: LED25.3 (DOUT), LED26.1 (DIN)
unnamed: LED26.3 (DOUT), LED27.1 (DIN)
unnamed: LED27.3 (DOUT), LED28.1 (DIN)
unnamed: LED28.3 (DOUT), LED29.1 (DIN)
unnamed: LED29.3 (DOUT), LED30.1 (DIN)
unnamed: LED30.3 (DOUT), LED31.1 (DIN)
unnamed: LED31.3 (DOUT), LED32.1 (DIN)
unnamed: LED32.3 (DOUT), LED33.1 (DIN)
unnamed: LED33.3 (DOUT), LED34.1 (DIN)
unnamed: LED34.3 (DOUT), LED35.1 (DIN)
unnamed: LED35.3 (DOUT), LED36.1 (DIN)
unnamed: Q2.2 (B), U3.2 (BASE)
unnamed: L1.2, Q2.1 (C), R7.1, U3.3 (AVDD)
unnamed: C6.1, R9.2, U3.8 (INA+)
unnamed: C6.2, R10.2, U3.7 (INA-)
unnamed: C5.1, U3.6 (VBG)
unnamed: R7.2, R8.1, U3.4 (VFB)

Notes on the sheet:
LEVELSHIFTER 3.3->5V
TASTER
ADC DRUCK ERKENNUNG
Load Cell / Wheatbridge
I2C-ANSCHLUSS
LED - 36MAL
"Trennung" von digitalen GND und analogen GND
MAGNETISCHER ENCODER
USB-INPUT
SENSOR
MICROCONTROLLER - ESP32-S3-WROOM-1U N16R8
MOTOR TREIBER
MIKROFON
LICHTSENSOR
SDO = 0; Abresse ist 0x76 SD0 = 1; Adresse ist 0x77
PULLUP UND PULLDOWN (POWER-ON-RESET)
ESD-SCHUTZ
DISPLAY-CONNECTOR

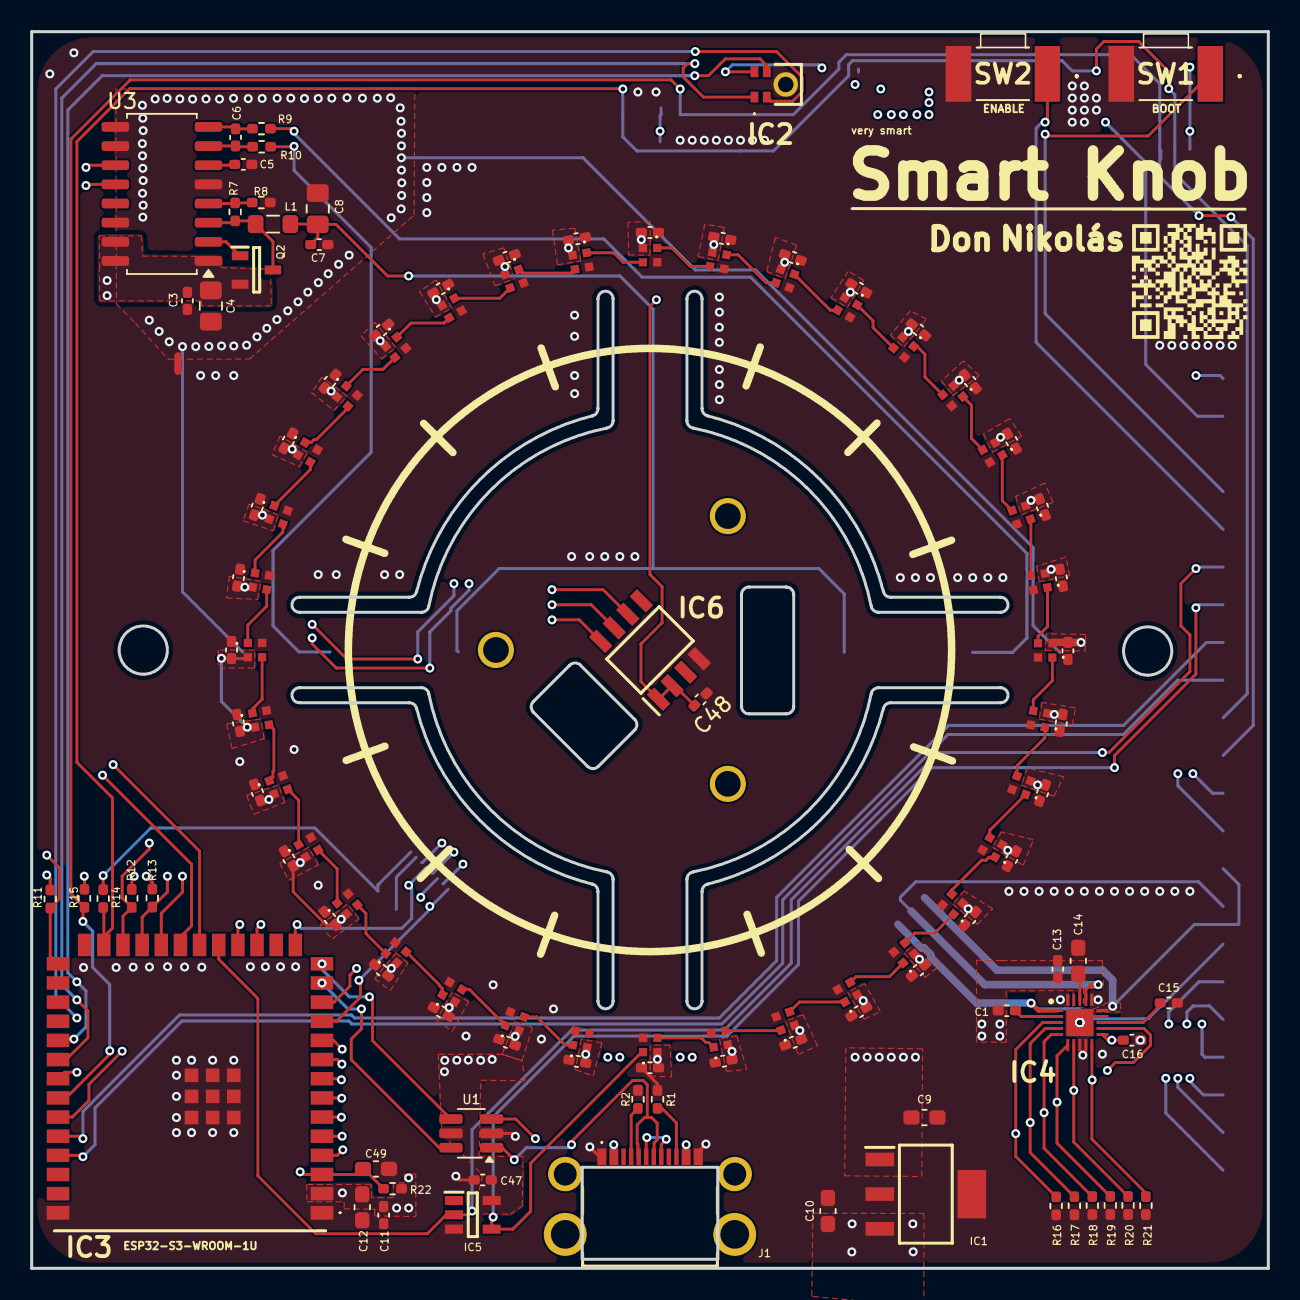
[picture p20: board SmartKnob-NB.kicad_pcb from above]

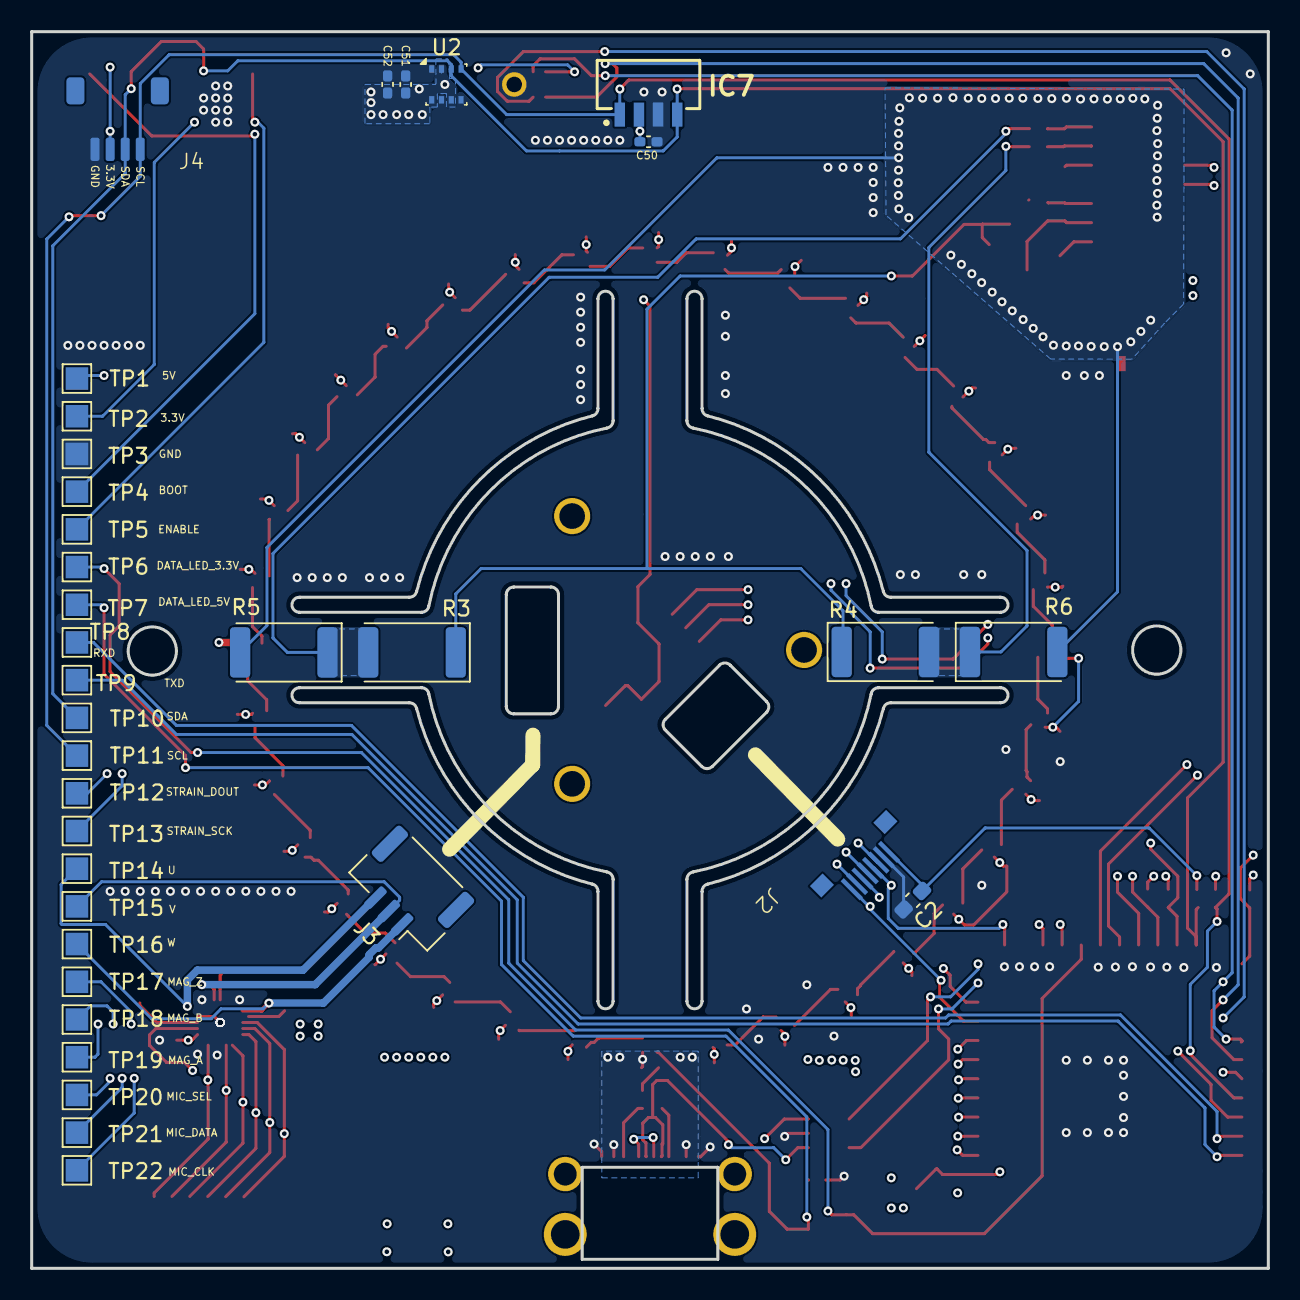
[picture p21: board SmartKnob-NB.kicad_pcb from below]

Board: 4 copper layers, 82.0 x 82.0 mm, 157 parts (35 on the bottom side), 88 nets.
