DonNikolas/SmartKnob-ESP32/reference/arduino-display-prototype/knob_fonts.c

// Knob Semibold: Montserrat-derived, weight 600, 4-bit coverage.
// Copyright 2024 The Montserrat.Git Project Authors. SIL OFL 1.1; see FONT_LICENSE.txt.
#include "knob_fonts.h"

static const uint8_t knob_font_14_bitmap[] = {
    0x1c,0xc1,0x1f,0xe0,0x1e,0xd0,0x0d,0xc0,0x0d,0xc0,0x0d,0xc0,0x09,0x80,0x00,0x00,0x2e,0xd1,0x2e,0xd1,
    0x01,0x10,0x3d,0x36,0xd1,0x3f,0x37,0xf1,0x3f,0x26,0xe0,0x2f,0x26,0xd0,0x02,0x01,0x20,0x00,0x00,0x00,
    0x00,0x00,0x00,0x00,0x00,0x00,0x00,0x00,0x00,0x00,0x00,0x00,0x00,0x0c,0x50,0x4c,0x10,0x00,0x0f,0x40,
    0x6e,0x00,0x27,0x8f,0x97,0xbe,0x75,0x3d,0xef,0xdd,0xfe,0xd9,0x00,0x6e,0x00,0xc9,0x00,0x00,0x8c,0x00,
    0xe5,0x00,0x8b,0xde,0xbb,0xfc,0xb2,0x7a,0xed,0xab,0xfb,0xa2,0x00,0xe6,0x04,0xf0,0x00,0x01,0xf4,0x07,
    0xe0,0x00,0x00,0x01,0x71,0x00,0x00,0x00,0x2f,0x20,0x00,0x01,0x8d,0xfe,0xa4,0x01,0xcf,0xce,0xbe,0xb0,
    0x4f,0x80,0xe1,0x12,0x04,0xfa,0x3e,0x10,0x00,0x1b,0xff,0xf8,0x30,0x00,0x06,0xbf,0xff,0x80,0x00,0x02,
    0xe5,0xcf,0x41,0x30,0x1e,0x07,0xf5,0x5f,0xb8,0xe9,0xfd,0x12,0x8e,0xff,0xfb,0x30,0x00,0x04,0xf3,0x00,
    0x00,0x00,0x1a,0x10,0x00,0x08,0xdd,0x40,0x00,0x8a,0x00,0x5e,0x37,0xd1,0x03,0xf4,0x00,0xaa,0x01,0xe3,
    0x0e,0x80,0x00,0x8c,0x02,0xf1,0x9d,0x00,0x00,0x2e,0xac,0x93,0xf2,0x35,0x00,0x02,0x86,0x1e,0x66,0xec,
    0xc1,0x00,0x00,0xac,0x0f,0x40,0xc8,0x00,0x05,0xf1,0x2e,0x10,0x9b,0x00,0x1f,0x60,0x1e,0x61,0xe7,0x00,
    0xab,0x00,0x05,0xdd,0xa1,0x00,0x10,0x00,0x00,0x12,0x00,0x00,0x4c,0xfd,0x50,0x00,0x02,0xec,0x6b,0xe2,
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
    .kern_dsc=NULL, .kern_scale=0, .cmap_num=1, .bpp=4, .kern_classes=0,
    .bitmap_format=0, .cache=&knob_font_52_cache
};
const lv_font_t knob_font_52 = {
    .get_glyph_dsc=lv_font_get_glyph_dsc_fmt_txt,
    .get_glyph_bitmap=lv_font_get_bitmap_fmt_txt,
    .line_height=40, .base_line=2,
    .subpx=LV_FONT_SUBPX_NONE, .underline_position=-2, .underline_thickness=1,
    .dsc=&knob_font_52_dsc
};
