DonNikolas/SmartKnob-ESP32/firmware/docs/tests/analyze_motor_profiles.py

import numpy as np
# User-provided profiles: interior points 1..31, excluding startup/turnaround.
f1=np.array([[239.681,43.480],[227.355,51.015],[217.053,44.381],[208.491,25.561],[195.226,39.666],[184.145,38.484],[175.053,23.378],[161.505,39.461],[152.231,25.633],[141.175,24.276],[132.041,9.459],[123.258,-7.810],[111.151,-1.811],[101.560,-13.420],[88.477,-0.594],[77.856,-4.993],[67.732,-12.873],[55.820,-8.243],[45.659,-15.863],[37.263,-35.840],[23.791,-20.291],[11.993,-16.456],[2.211,-26.732],[346.997,1.023],[336.256,-2.543],[323.558,7.594],[312.869,3.663],[302.658,-3.610],[288.514,16.653],[277.362,15.963],[262.524,41.080]])
r1=np.array([[258.265,70.895],[273.693,41.646],[285.462,38.014],[296.739,37.827],[309.682,25.971],[319.833,33.669],[333.020,20.109],[343.648,24.464],[356.665,12.092],[8.932,4.974],[20.821,0.498],[33.453,-9.172],[42.632,5.323],[52.520,14.859],[64.883,7.070],[75.085,14.401],[84.464,27.501],[98.377,8.862],[108.610,15.982],[118.159,27.884],[129.292,28.704],[137.911,47.125],[149.406,45.404],[158.573,59.987],[170.137,57.788],[181.250,58.745],[192.428,59.250],[204.789,51.474],[213.943,66.144],[223.969,74.715],[236.793,63.700]])
f2=np.array([[94.223,-18.315],[80.478,-0.846],[69.659,-3.869],[59.649,-12.548],[48.784,-15.242],[38.769,-23.885],[28.590,-31.379],[16.055,-22.388],[5.448,-26.890],[351.016,-4.618],[339.181,-0.522],[326.683,8.215],[315.731,6.130],[306.018,-4.628],[290.964,21.998],[280.654,15.419],[269.353,15.774],[253.503,47.973],[241.697,51.871],[231.445,44.883],[220.221,44.701],[210.053,37.129],[200.012,28.665],[187.841,35.109],[177.910,25.880],[164.987,37.587],[154.598,31.561],[143.915,27.589],[134.511,14.668],[126.104,-5.229],[113.252,5.981]])
r2=np.array([[110.563,24.803],[123.574,12.478],[132.116,31.436],[139.754,56.715],[152.283,47.768],[161.872,59.394],[172.603,63.028],[184.416,59.086],[195.607,59.495],[207.041,58.210],[217.199,65.851],[227.675,71.268],[239.062,70.311],[250.369,69.917],[262.986,60.349],[276.849,42.055],[287.532,46.021],[303.073,15.989],[313.064,24.801],[321.953,41.326],[336.481,18.383],[347.523,19.839],[359.626,13.867],[12.457,2.795],[24.223,-0.815],[35.948,-4.139],[45.953,4.574],[56.142,12.007],[67.109,13.984],[77.616,19.184],[88.979,18.393]])
for name,a,b in [('FWD',f1,f2),('REV',r1,r2)]:
 prediction=np.interp(b[:,0],a[:,0],a[:,1],period=360)
 error=b[:,1]-prediction
 print(name,'periodic interpolation correlation',np.corrcoef(prediction,b[:,1])[0,1],'RMS electric deg',np.sqrt(np.mean(error**2)),'max abs electric deg',max(abs(error)))
print('Mean zero difference electrical deg',np.rad2deg(5.118509-5.088051),'mechanical equivalent',np.rad2deg(5.118509-5.088051)/7)
print('Run2 direction gap interior mechanical mean',np.mean((r2[::-1,1]-f2[:,1])/7))
# Cross-validation: shared position model + direction-specific constant.
def features(a,d,k):
 t=np.deg2rad(a)
 return np.column_stack([np.ones(len(a)),np.full(len(a),d)]+[fn(n*t) for n in range(1,k+1) for fn in (np.sin,np.cos)])
for k in (1,2,3):
 X=np.vstack([features(f1[:,0],-1,k),features(r1[:,0],1,k)])
 y=np.r_[f1[:,1],r1[:,1]]
 beta=np.linalg.lstsq(X,y,rcond=None)[0]
 Y=np.vstack([features(f2[:,0],-1,k),features(r2[:,0],1,k)])
 e=np.r_[f2[:,1],r2[:,1]]-Y@beta
 print('harmonics',k,'run1 fit->run2 validation RMSE electrical',np.sqrt(np.mean(e**2)),'max abs',max(abs(e)),'coefficients',beta)
