DonNikolas/SmartKnob-ESP32/firmware/src/app_gui/home_feeds_config_defaults.h

#pragma once
// Public defaults: no endpoints, feed IDs or account details.
namespace KnobHomeConfig {
static constexpr const char* URLS[5] = {"", "", "", "", ""};
static constexpr char WARNING_PREFIX[] = "";
}
