DonNikolas/SmartKnob-ESP32/firmware/src/app_gui/knob_fonts.h

#ifndef KNOB_FONTS_H
#define KNOB_FONTS_H
#include <lvgl.h>
#ifdef __cplusplus
extern "C" {
#endif
LV_FONT_DECLARE(knob_font_14)
LV_FONT_DECLARE(knob_font_16)
LV_FONT_DECLARE(knob_font_18)
LV_FONT_DECLARE(knob_font_24)
LV_FONT_DECLARE(knob_font_52)
#ifdef __cplusplus
}
#endif
#endif
