DonNikolas/SmartKnob-ESP32/(commit log)

2026-10-05 Add KiCad schematics, PCB layout and Gerber files
    [SmartKnob-NB-B_Cu.gbr, SmartKnob-NB-B_Mask.gbr, SmartKnob-NB-B_Paste.gbr, SmartKnob-NB-B_Silkscreen.gbr, SmartKnob-NB-Edge_Cuts.gbr, SmartKnob-NB-F_Cu.gbr, SmartKnob-NB-F_Mask.gbr, SmartKnob-NB-F_Paste.gbr]
2026-10-06 test: add LED ring test and photos of working LEDs
2026-10-06 docs: add display concept and earlier Arduino prototype
2026-10-06 docs: add display prototype video and setup photo
2026-10-07 test: add microphone LED level display and demo video
2026-10-07 feat: add double-clap prototype and document pending tests
2026-10-08 test: add HX711 pressure-button tests and demo video
2026-10-08 test: add angle sensor test and document magnetic field warnings
2026-10-09 test: add angle sensor CRC checks and diagnostic results
2026-10-09 test: add initial motor test with results and demo video
2026-10-09 test: add motor calibration diagnostics and two offset profiles
2026-10-10 test: add four-detent motor test with results and demo video
2026-10-10 test: compare motor noise with brief sensor dropout handling
    [spring_comparison.cpp]
2026-10-12 feat: add pressure feedback with twelve motor detents
2026-10-12 feat: combine motor detents, press feedback, display and LEDs
2026-10-13 feat: add app GUI with motor controls, sensors and double-clap feedback
2026-10-14 hardware: split base and screen PCBs and update base 3D models
    [SmartKnob-NB-B_Cu.gbr, SmartKnob-NB-B_Mask.gbr, SmartKnob-NB-B_Paste.gbr, SmartKnob-NB-B_Silkscreen.gbr, SmartKnob-NB-Edge_Cuts.gbr, SmartKnob-NB-F_Cu.gbr, SmartKnob-NB-F_Mask.gbr, SmartKnob-NB-F_Paste.gbr]
2026-10-15 feat: add countdown timer and persistent app settings
2026-10-16 feat: add Boxtec home sensor app with demo and test documentation
2026-10-19 hardware: add enclosure V3 with diffuser, CAD files and print documentation
    [Base Enclosure V3.step, SmartKnob Enclosure Project.3mf, SmartKnob-Assembly.f3z]
2026-10-21 hardware: add enclosure V4 CAD files and update IR setup notes
    [Back Plate v3.step, Base Enclosure.step, Button Set.step, Display Spacer.step, Knob.step, Motor Shaft.step, Motor Spacer.step, Screen Platform.step]
2026-10-22 hardware: improve backplate fit and reduce display play
    Printed and assembled the revised parts. Backplate fits and the tighter screen platform reduces display movement. Slight plastic friction remains during rotation.
    [Back Plate v3.step, Back Plate v4.step, Screen Platform.step, SmartKnob Enclosure.f3z]
2026-10-27 fix: support bidirectional pressure input and document remaining limitations
    [Arduino.h, app_gui_main.cpp, background.cpp, drift-host.cpp, drift-log-host.py, haptic-input-host.cpp, haptic-integration-host.py]
2026-10-28 feat: add settings, MQTT preparation and experimental clap detection
    Add Wi-Fi setup, standby clock and Boxtec parsing fix. MQTT hardware validation and new clap detection device tests remain pending.
    [app_gui_main.cpp, background.cpp, boxtec-warning-host.cpp, clap-fft-host.cpp, clap-v2-host.cpp, clap_fft_detector.h, clap_fft_features.h, clap_fft_test.cpp]
2026-11-03 refactor: move pressure detection logic to C
2026-11-09 fix: move home sensor endpoints into private configuration
    [boxtec-warning-host.cpp, config.h, home-feeds-config-host.cpp, home_feeds.cpp, home_feeds.h, home_feeds_config.h, home_feeds_config_defaults.h]
